EasySensors/WallSocketInsertableNode/pdf/EbayPageReadme.md

### Wall Socket Insertable Node is extremely low profile wireless 220 Volts 10A Relay board. It switches on-off 220 Volts on its output terminals. It is suitable for installing into wall socket compartment in between the socket and the wall. The board height is only 13mm. Comes without plastic enclosure. Arduino IDE compatible (the Atmel ATMega328P) microcontroller with RFM 69 HW 433 MHz radio on board and current sensor. Best suitable for Home Automation, IOT.

## Features
- Fully compatible with the Arduino IDE (PRO MINI 8 MG Hz)
- Board Dimensions: Diameter is 55mm and Height is only 13mm
- Uncompromised protection:
   Overload varistor
   Slow fuse
   Thermal fuse
- It is 220 V version: Supply voltage 160-240 Volts AC
- Over the Air, firmware updates (OTA) ready. In combination with preprogrammed dual optiboot boot loader and external JDEC EPROM\Flash memory chip on board the node allows OTA software updates.
- Onboard RFM69-HW (high power version) 433 MHz radio transceiver with wire antenna
- Onboard Atmel ATSHA204A CryptoAuthentication chip makes communication with the node very secured. ATSHA204A implements secured handshake and if handshake fails the node will not executing any command sent to it
- Programming header is FTDI, TTL Serial. For programming, you need to have USB TTL Serial – FTDI adaptor
- MySensors compatible. You can use superb set of scripts and libraries from [mysensors.org](http://www.mysensors.org) project  and convert the node into reliable network of little home sensors, relays and actuators.
- Yes, it is open sourced. Completely

Comes with Arduino example sketch and guide to IOT, Smart home ideas.

## Overview
If you are familiar with Arduino boards, the MiniRelayBox node is Arduino pro Mini with onboard HopeRF RFM69-HW 433 MHz radio, external EPROM flash and crypto authentication chip. Comes with 10A relay and current sensor. To save some board dimensions the MiniRelayBox node does not have onboard USB-Serial converter. You need to buy FTDI Adapter for programming. HopeRF RFM69-HW provide extremely good range.  hundreds of meters in open area. External Flash chip allows burning Arduino sketch wirelessly. Onboard Atmel ATSHA204A CryptoAuthentication chip secures communication with other controllers. Some IOT ideas based on the Insertable Node and similar controllers plus complete specs you may find here [my GitHub page](https://github.com/EasySensors/WallSocketInsertableNode)

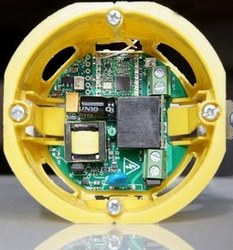
[picture p14: pics/WallSocketInsertableNode11.jpg]
Wall Socket Insertable Node

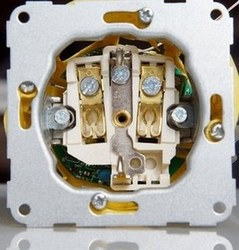
[picture p15: pics/WallSocketInsertableNode12.jpg]
Wall Socket Insertable Node

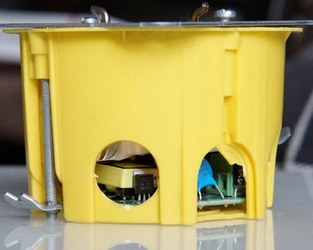
[picture p16: pics/WallSocketInsertableNode13.jpg]
Wall Socket Insertable Node

Wall Socket Insertable Node 
Wall Socket Insertable Node 
Wall Socket Insertable Node
Wall Socket Insertable Node

Package Content:
-	The Wall Socket Insertable board 1 pcs
-	JST wire connector male 1 pcs
