EasySensors/WallSocketInsertableNode/pics/LEDregular - Copy.jpg

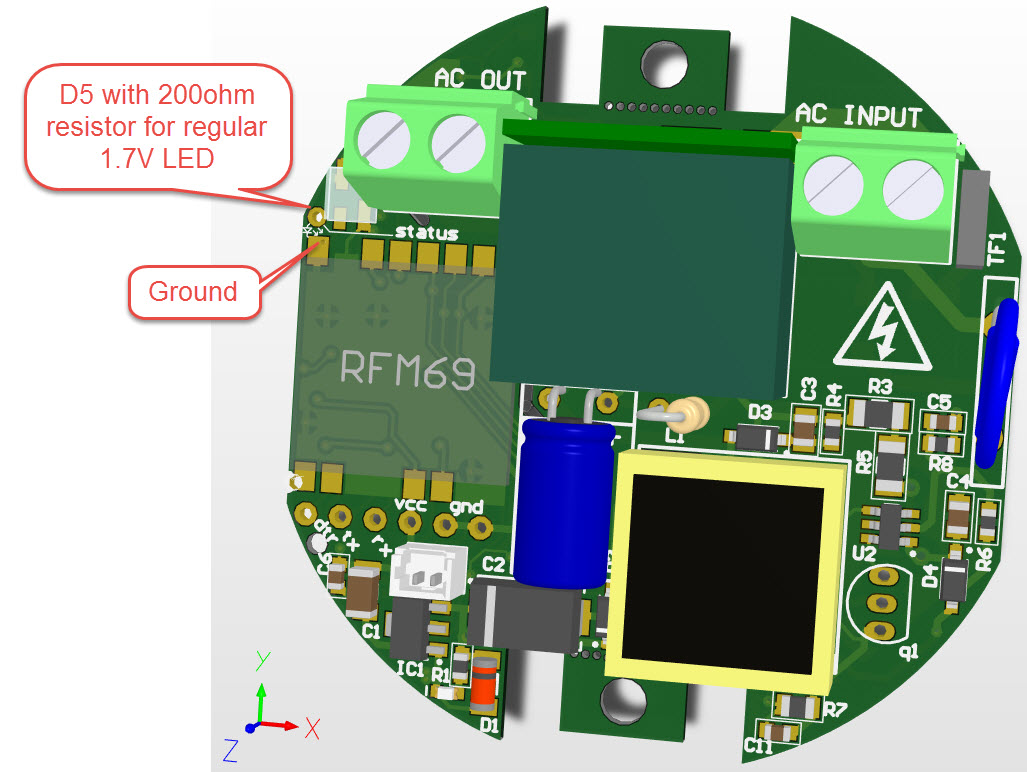
pics/LEDregular - Copy.jpg
