EasySensors/WallSocketInsertableNode/pics/Pins - Copy.jpg

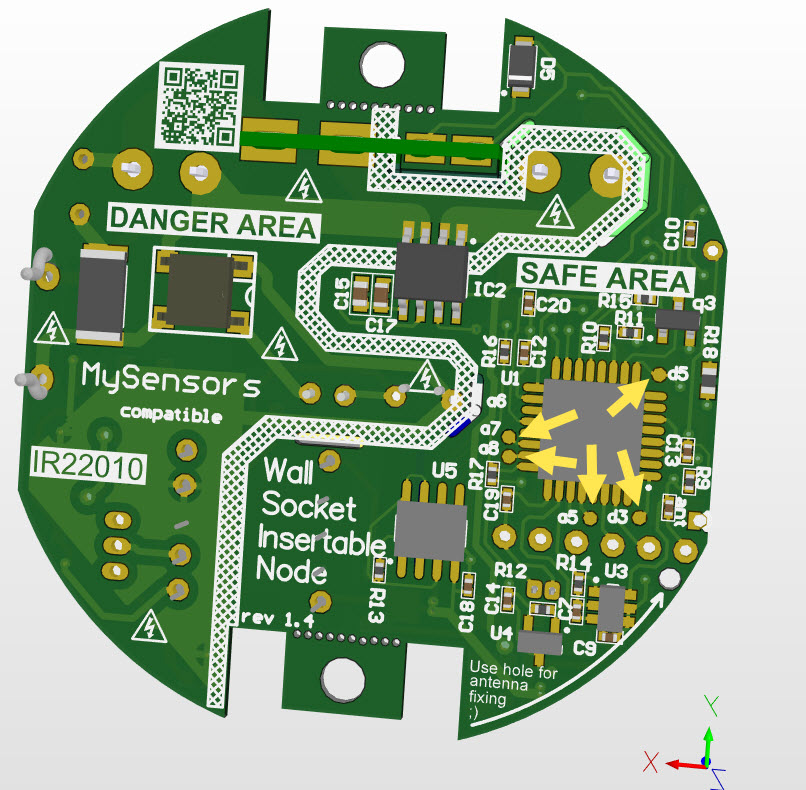
pics/Pins - Copy.jpg
