EasySensors/WallSocketInsertableNode/pics/socket_25_03_bottom.png

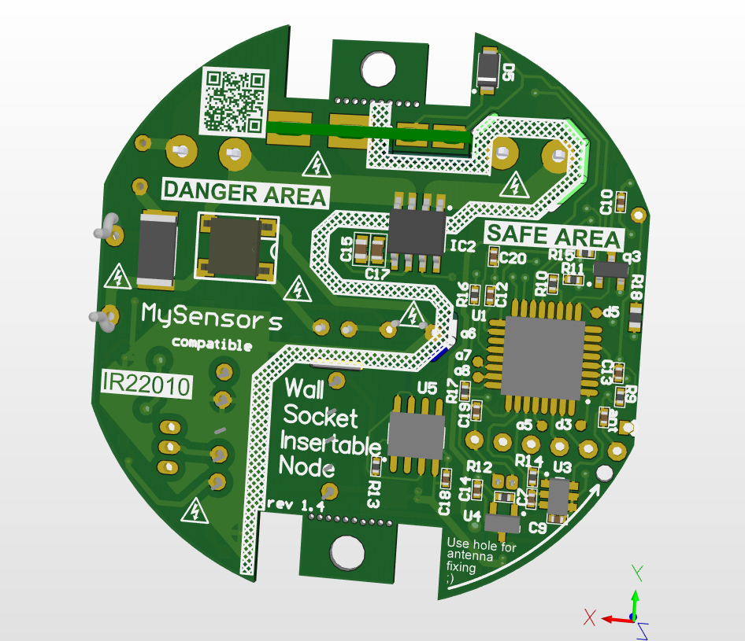
pics/socket_25_03_bottom.png
