EasySensors/WallSocketInsertableNode/pics/socket_25_03_top.png

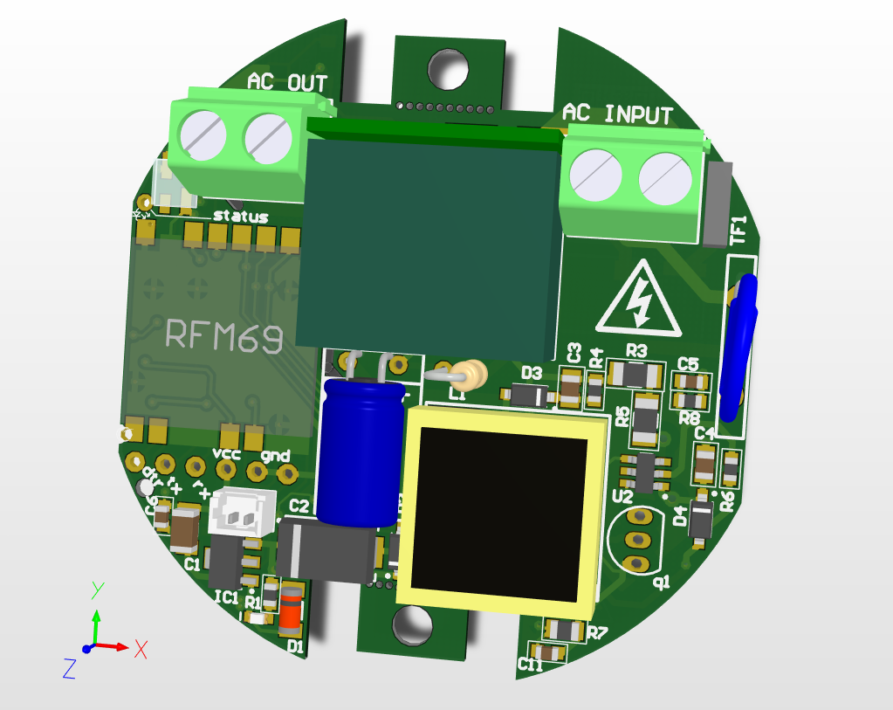
pics/socket_25_03_top.png
