EasySensors/WallSocketInsertableNode/pdf/WallInsertableSocket_sch.pdf

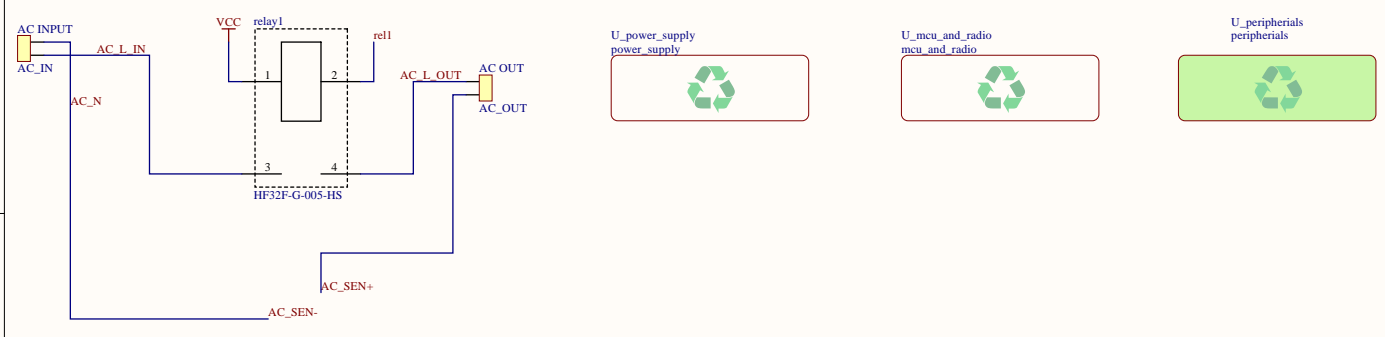
[picture p21: page 1]

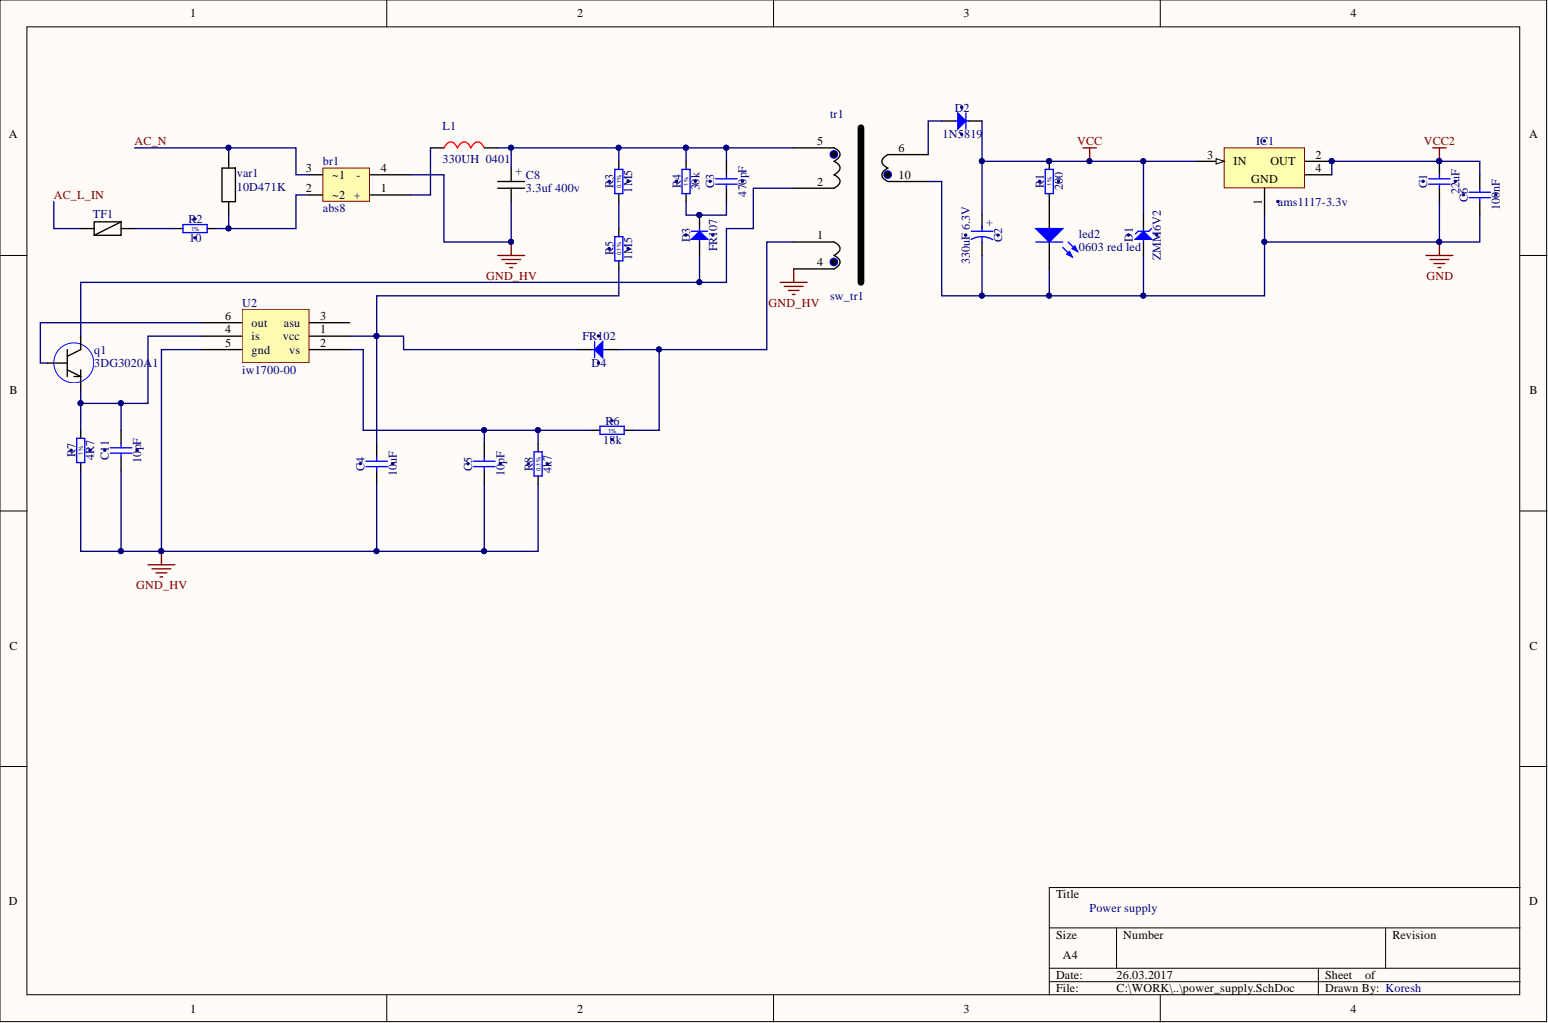
[picture p22: page 2]

var1 10D 4 7 1 K 2 | 1

led 2 | 4

5 | g n d v s | 2

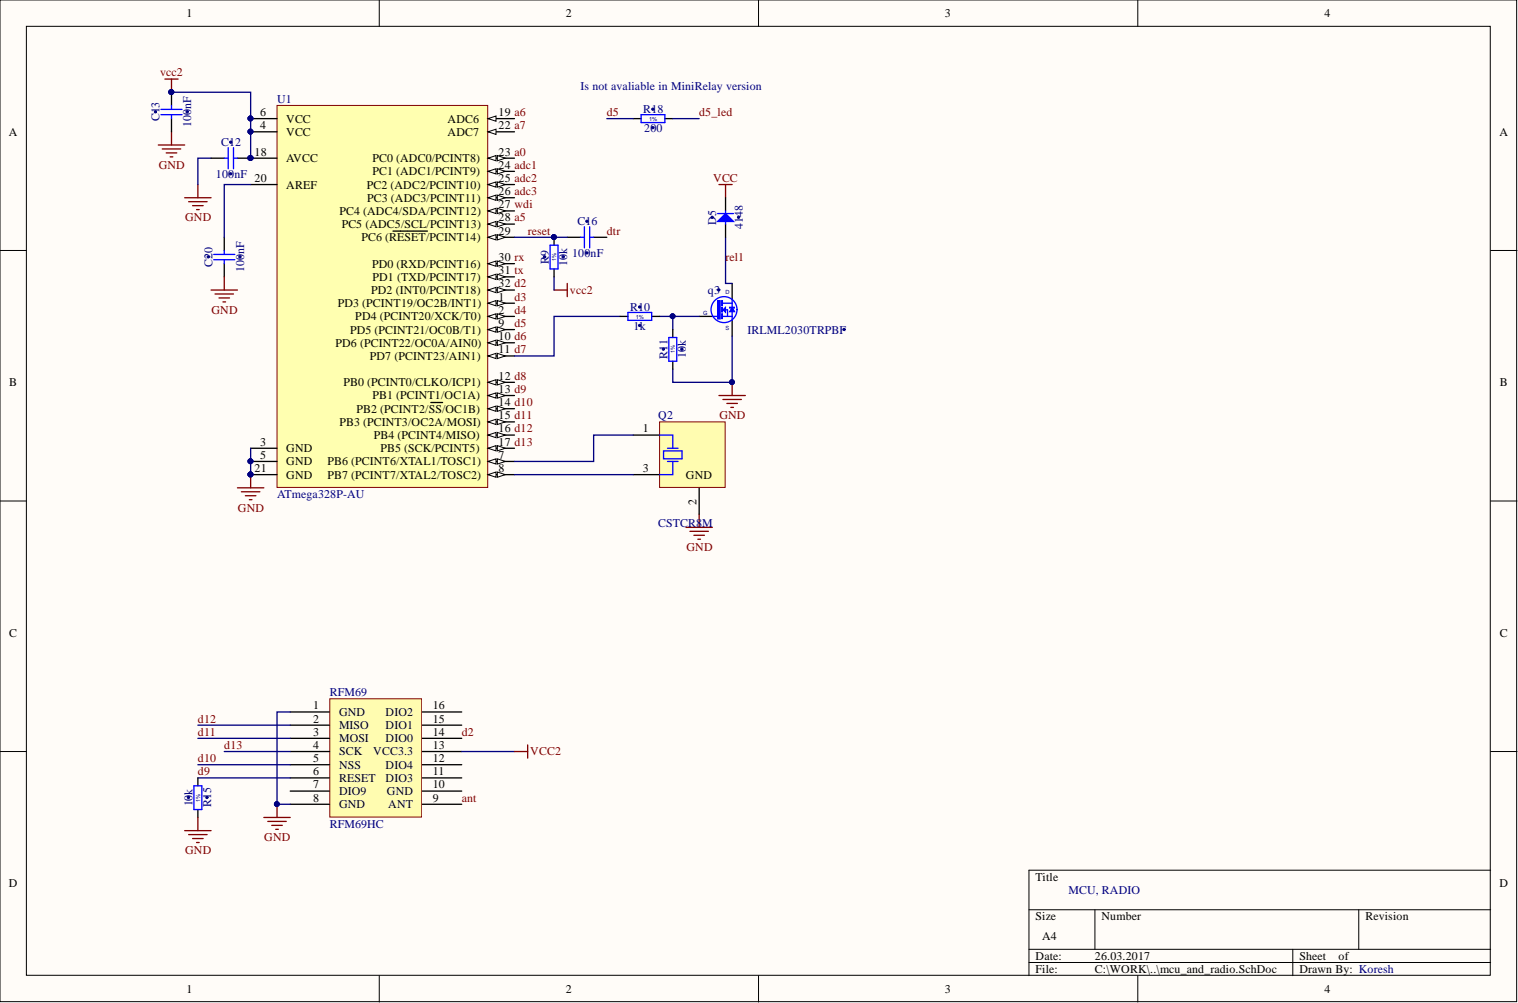
[picture p23: page 3]

Is not avaliable in MiniRelay version

MISO 2
MOSI 3
SCK 4
NSS 5
RESET 6
DIO9 7

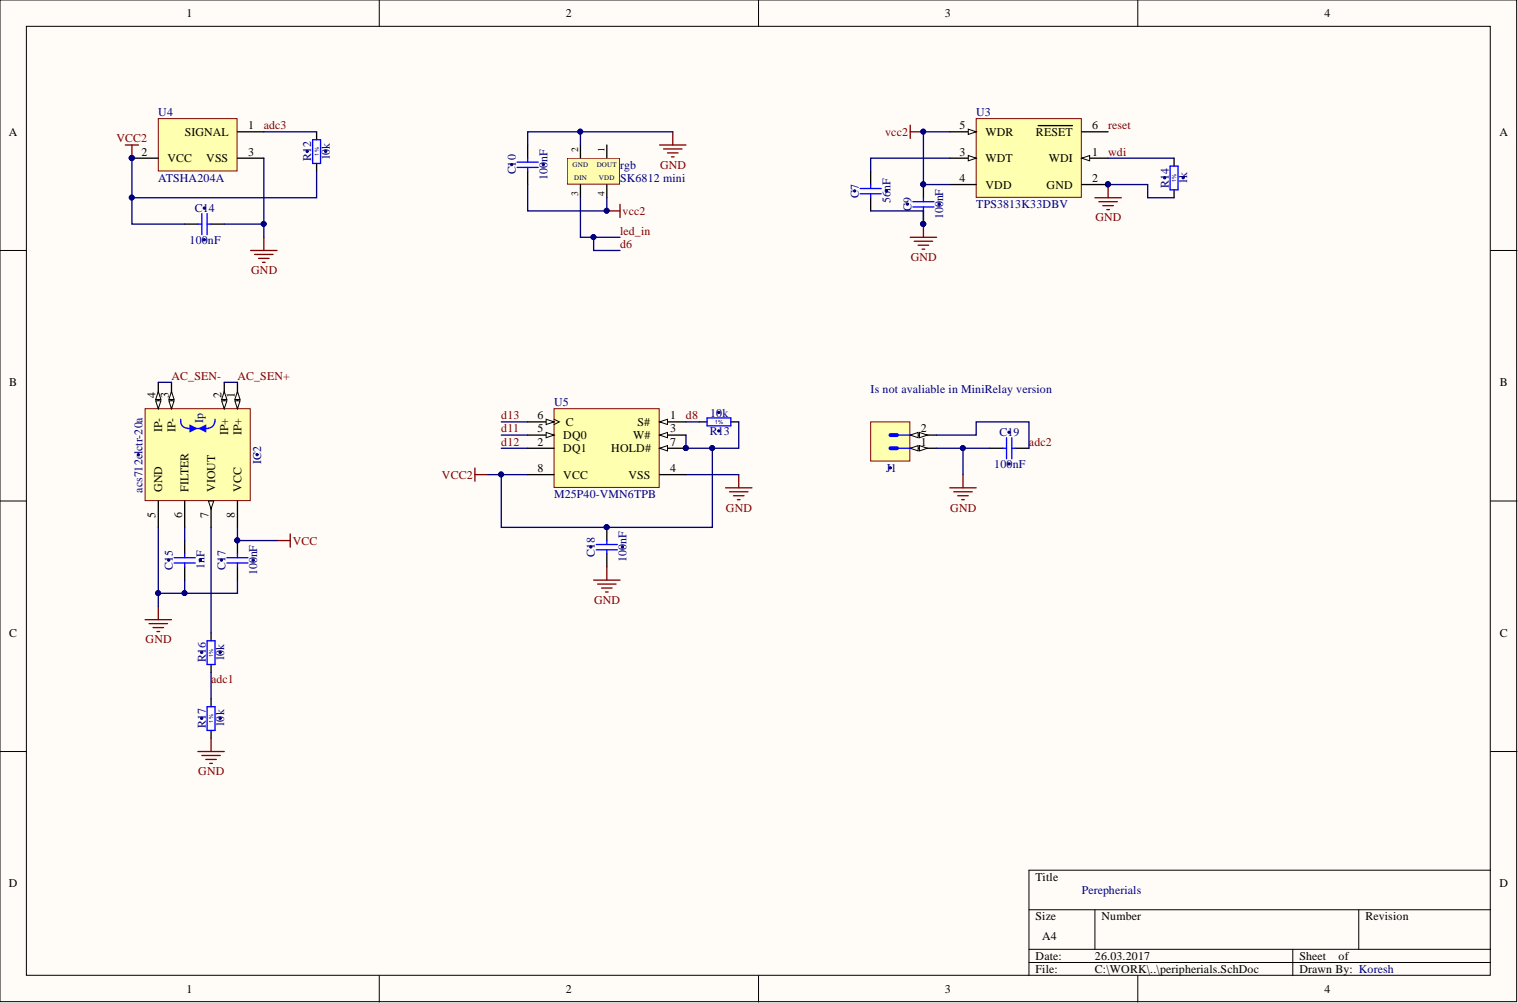
[picture p24: page 4]

Is not avaliable in MiniRelay version
