EasySensors/WallSocketInsertableNode/WallSocketInsertableNode.ino

/**
 * The MySensors Arduino library handles the wireless radio link and protocol
 * between your home built sensors/actuators and HA controller of choice.
 * The sensors forms a self healing radio network with optional repeaters. Each
 * repeater and gateway builds a routing tables in EEPROM which keeps track of the
 * network topology allowing messages to be routed to nodes.
 *
 * Created by Henrik Ekblad <henrik.ekblad@mysensors.org>
 * Copyright (C) 2013-2015 Sensnology AB
 * Full contributor list: https://github.com/mysensors/Arduino/graphs/contributors
 *
 * Documentation: http://www.mysensors.org
 * Support Forum: http://forum.mysensors.org
 *
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
**/



// Enable debug prints to serial monitor
#define MY_DEBUG

// Enable  onbaord Pixel LED SK6812mini 
#define AdafruitNeoPixel 

// Comment it out for Auto Node ID #
#define MY_NODE_ID 0xC2 

// Enable and select radio type attached
#define MY_RADIO_RFM69
//#define MY_RFM69_NEW_DRIVER 

// MySensors 2.0
#define MY_RFM69_FREQUENCY   RF69_433MHZ
//#define MY_RFM69_FREQUENCY   RF69_868MHZ
//#define MY_RFM69_FREQUENCY   RF69_915MHZ


// MySensors 2.2 and up style 
//#define MY_RFM69_FREQUENCY RFM69_868MHZ
//#define MY_RFM69_FREQUENCY RFM69_433MHZ
//#define MY_RFM69_FREQUENCY RFM69_915MHZ

#define MY_IS_RFM69HW

//Enable OTA feature
#define MY_OTA_FIRMWARE_FEATURE
#define MY_OTA_FLASH_JDECID 0 //0x2020

//Enable Crypto Authentication to secure the node
//#define MY_SIGNING_ATSHA204
//#define  MY_SIGNING_REQUEST_SIGNATURES

// Type of switch connected to the white JST connector on the board. A2 arduino Pin
// Momentary is notebook\laptop keyboard style key.
#define MOMENTARY_SWITCH

#ifdef  AdafruitNeoPixel
#include <Adafruit_NeoPixel.h>
// Which pin on the Arduino is connected to the NeoPixels?
#define PIN 6
// How many NeoPixels are attached to the Arduino?
#define NUMPIXELS   1
#define NEO_PTYPE  NEO_GRB 1
Adafruit_NeoPixel pixels = Adafruit_NeoPixel(NUMPIXELS, PIN, NEO_GRB + NEO_KHZ800);
#endif

#include <avr/wdt.h>
#ifdef  __AVR__
  #include <avr/power.h>
#endif

#include <MySensors.h>
#include <stdlib.h>

//--------------------- https://github.com/JonHub/Filters
#include <Filters.h> 
float testFrequency = 50;                     // test signal frequency (Hz)
float windowLength = 20.0/testFrequency;     // how long to average the signal, for statistist

#define RELAY_pin 7 // Digital pin connected to relay

#define RELAY_sensor 1
#define Current_sensor 2
#define TEMP_sensor 3

#define RELAY_ON 1  // GPIO value to write to turn on attached relay
#define RELAY_OFF 0 // GPIO value to write to turn off attached relay

//#define SPIFLASH_BLOCKERASE_32K   0x52
#define SPIFLASH_BLOCKERASE_32K   0xD8 // Redefine erase block and CHIPERASE commands here. so please keep these two lines AFTER #include <MySensors.h>
#define SPIFLASH_CHIPERASE        0x60

MyMessage msg(RELAY_sensor, V_LIGHT);
MyMessage msg_current(Current_sensor, V_CURRENT);
MyMessage msg_temp(TEMP_sensor, V_TEMP);

RunningStatistics inputStats;                 // create statistics to look at the raw test signal

static uint8_t  value_ext_sw = HIGH, last_value_ext_sw = HIGH;
static uint8_t  temp_rfmPrevoiusReadings = 0;
static float ACS712AmpsPrevoiusReadings = 0;

#include <Bounce2.h>
Bounce debouncer = Bounce(); 

void reportCurrent()
{
  float ACS712amps;
  char amps_txt[10];
  char temp_txt[10];
  // The temperature reading is depricated in New RFM 69 driver
  int temp_rfm = (int)_radio.readTemperature(0);
  
  //It is linear regression for amperes against onboard ACS712 sigma eadings
  ACS712amps  = 0.05856*inputStats.sigma() - 0.2126;
  //convert it to a string
  dtostrf(ACS712amps,0,2,amps_txt);   
  
  if (abs( (ACS712amps -  ACS712AmpsPrevoiusReadings)) > 0.1  && ACS712amps > 0){
      ACS712AmpsPrevoiusReadings = ACS712amps;
      wait(100);
      send(msg_current.set(amps_txt), true); // Send new state and request ack back
    }

  if (abs(temp_rfmPrevoiusReadings - temp_rfm)>= 3){
      temp_rfmPrevoiusReadings = temp_rfm;
      Serial.print( "\tRFM temp: " ); Serial.println( temp_rfm );
      wait(100);
      send(msg_temp.set(temp_rfm), true); // Send RFM module temp sensor readings
    }
}

void before() {
    // watchdog sets to 8 secs
    wdt_enable(WDTO_8S);     //wdt_disable();
    // in case watchdog resets node - we do RFM69 reset here since VDD (power) is not disconnected while watchdog resets the node. Just in case!
    /*  RFM reset pin is 9
     *  A manual reset of the RFM69HCW\CW is possible even for applications in which VDD cannot be physically disconnected.
     *  Pin RESET should be pulled high for a hundred microseconds, and then released. The user should then wait for 5 ms
     *  before using the module.
     */
    pinMode(9, OUTPUT);
    //reset RFM module
    digitalWrite(9, 1);
    delay(1);
    // set Pin 9 to high impedance
    pinMode(9, INPUT);
    delay(10);
      
    // External button with JST connector
    pinMode(A2, INPUT_PULLUP);
    digitalWrite(A2,HIGH); 
    
    // Debouncing the button
    debouncer.attach(A2);
    debouncer.interval(20);

    #ifdef  AdafruitNeoPixel
      pixels.begin();
      pixels.setPixelColor(0,pixels.Color(0,0,255)); // R G B 
      pixels.setBrightness(50); //0-255
      pixels.show();
    #endif
    
    // Call void amps() to update current and temperature readings.
    inputStats.setWindowSecs( windowLength );
    // Then set relay pins in output mode
    pinMode(RELAY_pin, OUTPUT);  
    // Set relay to last known state (using eeprom storage)
    digitalWrite(RELAY_pin, loadState(RELAY_sensor)?RELAY_ON:RELAY_OFF);

    #ifdef  AdafruitNeoPixel
      pixels.setPixelColor(0,loadState(RELAY_sensor)?pixels.Color(255,0,0):pixels.Color(0,255,0));
      pixels.show();
    #endif
    //_radio.readAllRegs();
}

void setup() {
  
}

void presentation() 
{  
  // Send the sketch version information to the gateway and Controller
  sendSketchInfo("Insertable Relay node","2.0");

  // Register all sensors to gw (they will be created as child devices)
  present(RELAY_sensor, S_LIGHT);
  present(Current_sensor, S_MULTIMETER);
  present(TEMP_sensor, S_TEMP); // RFM 69 Radio have temp sensor. keep this if you like temp reported to a controller
}

void loop()
{
  boolean loadedState;
  wdt_reset();
  //Serial.print("RSSI "); Serial.println(_radio.readRSSI());

  #ifdef MOMENTARY_SWITCH
        // read and debounced digitalRead(A2);
        debouncer.update();
        value_ext_sw = debouncer.read();
        if (value_ext_sw == 0 && last_value_ext_sw == 1){ 
          loadedState = loadState(RELAY_sensor) == 1? true:false;
            // Change relay state
            digitalWrite(RELAY_pin, !loadedState?RELAY_ON:RELAY_OFF);
            
            #ifdef  AdafruitNeoPixel
              pixels.setPixelColor(0,!loadedState ?pixels.Color(255,0,0):pixels.Color(0,255,0));
              pixels.show();
              wait(100);
            #endif
            
            // Store state into eeprom
            saveState(RELAY_sensor, !loadedState?RELAY_ON:RELAY_OFF);
            // update controller with new relays state
            msg.setDestination(0); 
            send(msg.set(!loadedState?RELAY_ON:RELAY_OFF), true);
            last_value_ext_sw = value_ext_sw;
          }
          else {
            last_value_ext_sw = value_ext_sw;
          }
          
  #else
        // read and debounce digitalRead(A2);
        debouncer.update();
        value_ext_sw = debouncer.read();
        if (last_value_ext_sw != value_ext_sw){
          last_value_ext_sw = value_ext_sw;
          //Serial.println("VALUE"); Serial.println(value_ext_sw);
          // Change relay state
          digitalWrite(RELAY_pin, value_ext_sw?RELAY_ON:RELAY_OFF);

          #ifdef  AdafruitNeoPixel
            pixels.setPixelColor(0,!loadedState ?pixels.Color(255,0,0):pixels.Color(0,255,0));
            pixels.show();
            wait(100);
          #endif
          
          // Store state into eeprom
          saveState(RELAY_sensor, value_ext_sw?RELAY_ON:RELAY_OFF);
          msg.setDestination(0); 
          send(msg.set(value_ext_sw?RELAY_ON:RELAY_OFF), true);
          }
  #endif
  inputStats.input(analogRead(A1));  // log to Stats function for ampers from A1 analog input
  static unsigned long lastCurrentSensorMillis = 0, currentSensorInterval = 5000;
  // Check if we reach the max millis of 4,294,967,295
  millis() < lastCurrentSensorMillis ? lastCurrentSensorMillis = 0:0;
  if (millis() >  (lastCurrentSensorMillis + currentSensorInterval)){
    lastCurrentSensorMillis = millis();
    reportCurrent();    
  }
}

void receive(const MyMessage &message) {
  // We only expect one type of message from controller. But we better check anyway.
  if (message.type==V_LIGHT) {
     // Change relay state
     digitalWrite(RELAY_pin, message.getBool()?RELAY_ON:RELAY_OFF);
     // Store state in eeprom
     saveState(message.sensor, message.getBool()?RELAY_ON:RELAY_OFF);
     #ifdef  AdafruitNeoPixel
      wait(100);
      // Blink blue light to see radio communication with the gateway is 
      pixels.setPixelColor(0,pixels.Color(0,0,255));
      pixels.show();
      wait(100);
      // Set Red for ON and green fo OFF
      pixels.setPixelColor(0,message.getBool() ?pixels.Color(255,0,0):pixels.Color(0,255,0));
      pixels.show();
     #endif
     Serial.print("Incoming change for sensor:");
     Serial.print(message.sensor);
     Serial.print(", New status: ");
     Serial.println(message.getBool());
   }
}
