EasySensors/WallSocketInsertableNode/(commit log)

2017-04-05 timer lib removed
2017-11-08 ftdi power option
2018-05-27 RFM69 reset pin
    set to high impedance after controller reboot
    [WallSocketInsertableNode.ino]
