EasySensors/WallSocketInsertableNode/(notices)

Notices in the files:
WallSocketInsertableNode.ino:
modify it under the terms of the GNU General Public License
